georgestephanis/pi-cemaker/(commit log)

2026-09-30 feat: initial firmware, hardware circuit design, and construction notice
    - Add prominent prototype / under construction warning to README
    - Add RP2040 TinyUSB HID Power Device (0x84/0x85) & CDC serial firmware
    - Add telemetry sampling, 2S SoC lookup, and 45s zombie halt power-cut logic
    - Add host test suite and desktop interactive CLI simulator runner
    - Add hardware schematic specification covering 6 power & control subsystems
    - Add Bill of Materials (BOM.md & BOM.csv) with MPNs and distributor part numbers
    - Add PCB layout & thermal design guidelines for 5.1V @ 5A (25.5W) continuous load
    - Add initial KiCad 7/8 project files, schematic, and board layout
    [BOM.csv, pi-cemaker.kicad_pcb, pi-cemaker.kicad_sch]
2026-09-30 docs: align documentation with implementation and add prototype warnings
    - Update AGENTS.md repository tree to reflect firmware and hardware structure
    - Align RP2040 ADC and GPIO assignments in ARCHITECTURE.md with implementation
    - Update USB_HID_UPS_SPEC.md with 7-byte Status and 5-byte Config HID report formats
    - Update FIRMWARE_ROADMAP.md marking Phase 1 & core simulation as complete
    - Update CRITICAL_CONSIDERATIONS.md with GPIO15/GPIO14 specifics
    - Add prototype / not for sale warning notices across all documentation files
2026-10-01 docs: rewrite AGENTS.md from review findings and add modular PoC build (#21)
    AGENTS.md now leads with what actually exists vs. what is aspirational,
    links the review issues, and lists safety invariants and gotchas.
    hardware/POC_MODULAR.md describes a hand-solderable build from commercial
    modules on a minimal signal-only carrier.
2026-10-01 build: guard host targets from Pico SDK builds, add host-test CI (#27)
    Fixes #18 (host targets and CI; the device build itself remains untested).
2026-10-01 fix(power_mgr): hold a manual 5V cut against the state machine
    Fixes #2. Cutting the rail from the CLI now holds until the rail is
    manually re-enabled; previously the next tick re-asserted it.
    [power_mgr.c, power_mgr.h]
2026-10-01 fix(power_mgr): always complete the shutdown cut and enforce a minimum off time
    Fixes #1. Mains returning during the 45 s countdown no longer cancels the
    cut (the OS may already be halted with 5V applied), and the rail now stays
    off for POWER_CUT_MIN_OFF_MS before re-energizing so the Pi 5 PMIC resets.
    The CLI 'shutdown' command with mains present now cycles the rail.
    [power_mgr.c, power_mgr.h]
2026-10-01 fix: correct pack capacity to 3000 mAh; flag otg_mode and CC current claims
    Partially addresses #4 (capacity constant), #6 and #7 (documentation only).
    [main.c, telemetry.c, telemetry.h]
2026-10-01 refactor(power_mgr): wake the Pi by power-button pulse instead of cutting the rail
    Implements the redesign in #13: remove POWER_CUT, REBOOTING and
    DORMANT_SLEEP. After the countdown the state is HALTED with the rail on;
    returning mains presses the Pi 5 power button once. This also removes the
    dormant stub (#3) and the minimum-off-time guess from #1.
    [cli.c, power_mgr.c, power_mgr.h]
2026-10-01 docs: update for power-button wake redesign and removed dormant sleep
